monstergabbysolos/igcar-ovality-meter/images/README.md

# Images

Add your instrument photos here:

- `igcar-1.jpg` — Front view showing OLED and buttons
- `igcar-2.jpg` — Jaws measuring an actual pipe
- `igcar-3.jpg` — OLED showing ovality percentage result
- `enclosure_full.jpg` — Complete assembled instrument
- `circuit_inside.jpg` — Internal wiring (optional)

Photos make the repository significantly more impactful for
IGCAR documentation, NTU portfolio, and future employers.
