monstergabbysolos/igcar-ovality-meter/cad/README.md

# CAD Files

## Coil Tube v3 — 2mm Grooves (Recommended)

**File:** `coil_tube_58mm_v3.step`

Specifications:
- Length: 58mm total
- OD: 19mm | ID: 11mm | Wall: 4mm
- 18 grooves × 2mm wide × 1mm deep
- 1mm land between grooves
- Deep marker groove at 5mm (assembly zero reference)
- Wire exit notches at both ends

Print settings:
- Material: PETG, 100% infill
- Layer height: 0.12mm
- Orient: tube axis vertical (gives cleanest grooves)
- No supports needed

## Housing v6 — Vernier Caliper Style

**File:** `ovality_v6_caliper_style.step`

Specifications:
- Body: 212 × 44 × 28mm
- Max jaw opening: 37mm
- Electronics bay: 85 × 36 × 40mm
- Friction slider with M2 lock screw
- 5 printed parts: main beam, carriage, lid, coil tube, battery door

## Download

CAD files are available from the project releases page.
Contact the author for the STEP files directly.
