monstergabbysolos/igcar-ovality-meter/docs/technical_report.md

# Technical Report

The complete technical report is available as a Word document in the project releases:
**`ovality_meter_report.docx`**

## Contents

1. Abstract
2. Introduction & Reference Paper
3. Principle of Operation (Ovality formula, LDC1612 sensing chain)
4. System Architecture (Block diagram, Component specs)
5. Circuit Connections (Full wiring table)
6. Mechanical Design (Dimensions, coil winding, friction slider)
7. Firmware Architecture (State machine, button latch, calibration system)
8. Complete Source Code
9. Novel Contributions vs Reference Paper
10. Measurement Procedure
11. Power Management
12. Conclusion & References

## Reference

S. Ramesh, M. P. Rajiniganth, and P. Sahoo, *"Deployment of Inductance-Based Pulsating Sensor Toward Development of Measurement Technique for Ovality in Pipe,"* IEEE Transactions on Instrumentation and Measurement, 2016.
